awesomelena/cordic-digital-upconverter/docs/phase1-report.pdf

PROJEKTNI ZADATAK - FAZA 1 | 1

# Hardversko-softverska obrada signala

# Projektni zadatak - Prva faza

Magdalena Savic, 2022/0351 ´

Sažetak—U ovom izvještaju je analizirana i predložena efikasna arhitektura interpolatora za promjenu ucestanosti odabira- ˇ nja signala M = 16 puta. Predložena je kaskadna realizacija sa cetiri stepena, od kojih su prva tri poluopsežni filtri. Pored ˇ toga, definisani su parametri za realizaciju kompleksnog mje-
šaca primjenom CORDIC algoritma. Odre ˇ | deni su koeficijenti ¯
kompenzacionog FIR filtra koji poništava slabljenje NRZ DAC-a u osnovnom opsegu, a na kraju je teorijski proracunato ˇ maksimalno dozvoljeno podrhtavanje takta (jitter) sistema.
I. ARHITEKTURA INTERPOLATORA

Potrebno je dizajnirati interpolator sa odnosom promjene
ucestanosti od ˇ | M = 16. Ulazni kompleksni signal ima uce- ˇ
stanost odabiranja fs = 61.44 MHz, a korisni signal zauzima opseg fmax = ±25 MHz. Umjesto direktne implementacije, koja bi zahtijevala veoma dugacak filtar zbog uske tranzicione ˇ zone, predlaže se kaskadna arhitektura od cetiri stepena inter- ˇ polacije sa faktorima M1 = M2 = M3 = M4 = 2. Arhitektura

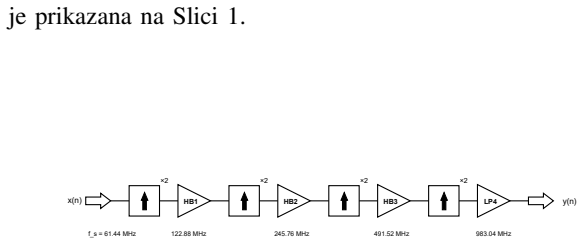
[picture p1: figure]
je prikazana na Slici 1.; f_s = 61.44 MHz; 122.88 MHz; 245.76 MHz; 491.52 MHz; 983.04 MHz

Slika 1. Predložena kaskadna arhitektura interpolatora (M = 16).

Korišcenjem kaskadne realizacije, prva tri stepena mogu ´ se realizovati kao poluopsežni (half-band) filtri, što znacaj- ˇ no smanjuje hardversku složenost jer je približno polovina koeficijenata jednaka nuli. Posljednji stepen ima najblažu tranzicionu zonu i realizuje se opštim low-pass filtrom.

A. Dizajn filtara i graniˇcne uˇcestanosti
Za svaki stepen odredene su grani ¯ | cne u ˇ | cestanosti (izražene ˇ
u odnosu na izlaznu ucestanost tog stepena) i broj koeficijenata ˇ potreban da se obezbijedi slabljenje replika od AdB = 60 dB.
Filtri su projektovani koristeci funkcije ´ | | remezhb i remezlp.
Rezultati su dati u Tabeli I.
Amplitudske karakteristike sva cetiri filtra prikazane su na ˇ Slici 2.

Univerzitet u Beogradu, Elektrotehnicki fakultet. Predmet: Hardversko- ˇ softverska obrada signala (13E044HSOS).

Tabela I
PARAMETRI STEPENA INTERPOLATORA.
Stepen | Ni | ful [MHz] | Fpass | Fstop | MOPs
HB1 (M=2) | 39 | 61.44 | 0.2035 | 0.2965 | 2396.2
HB2 (M=2) | 11 | 122.88 | 0.1017 | 0.3983 | 1351.7
HB3 (M=2) | 7 | 245.76 | 0.0509 | 0.4491 | 1720.3
LP4 (M=2) | 6 | 491.52 | 0.0254 | 0.4746 | 2949.1
Ukupno | | | | | 8417.3

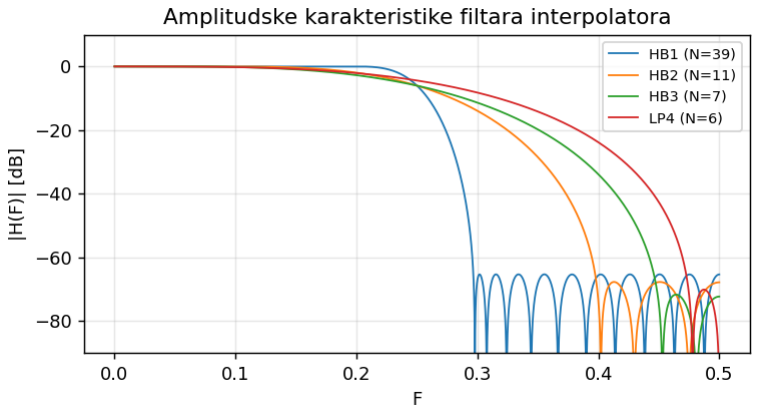
[picture p2: figure]

Slika 2. Amplitudske karakteristike filtara interpolatora.

B. Procjena broja operacija

Za polifaznu realizaciju, broj operacija u sekundi (množenje i sabiranje) zavisi od ulazne ucestanosti svakog stepena: ˇ

Nop = N1fs + N2(2fs) + N3(4fs) + N4(8fs)
≈ 8417.3 MOPs. | (1)

Ukoliko bi se implementirala direktna interpolacija (M = 16 u jednom koraku), tranziciona zona bi iznosila ∆F = (fs − fmax)/(16fs) ≈ 0.01164, što zahtijeva filtar dužine Ndir ≈ AdB/(22 ∆F) ≈ 235. U direktnoj implementaciji pretpostavlja se realizacija bez optimizacija, pa je broj operacija prosto:

Nop,dir = Ndir · fs ≈ 235 · 61.44 ≈ 14438.4 MOPs. (2)

Može se zakljuciti da kaskadna implementacija smanjuje broj ˇ operacija 14438.4/8417.3 ≈ 1.72 puta, uz znatnu uštedu na memoriji za koeficijente. Takode, pošto su prva tri filtra ¯ poluopsežna, praktican broj množenja je još manji. ˇ

C. Spektri signala u svim granama arhitekture

Spektar ulaznog signala prikazan je na Slici 3. Signal zauzima opseg od −25 do +25 MHz i nije konjugovanokompleksno simetrican. ˇ

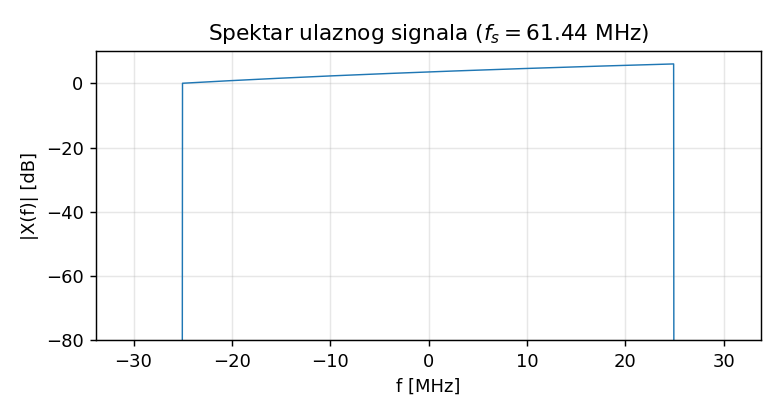
[picture p3: figure]

Slika 3. Spektar ulaznog signala (fs = 61.44 MHz).

Nakon svakog ekspandera, u spektru se pojavljuju spektralne replike, koje se zatim potiskuju odgovarajucim filtrom. ´ Slike 4–6 prikazuju spektar signala nakon ekspandera (sa ucrtanom idealnom granicom filtra) i nakon filtriranja, za prva tri (half-band) stepena.

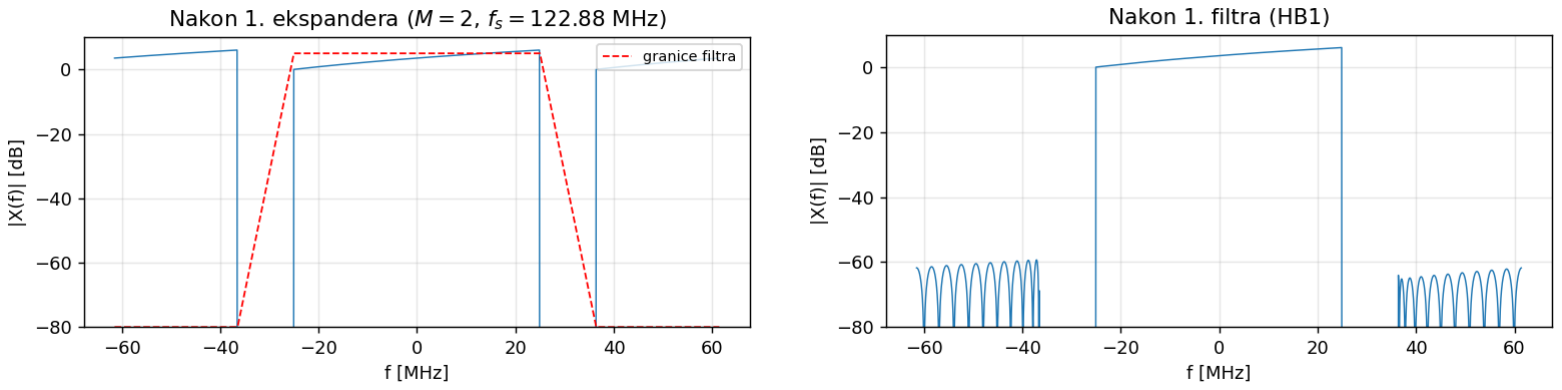
[picture p4: figure]

Slika 4. Prvi stepen (M = 2): spektar nakon ekspandera (lijevo) i nakon filtra HB1 (desno).

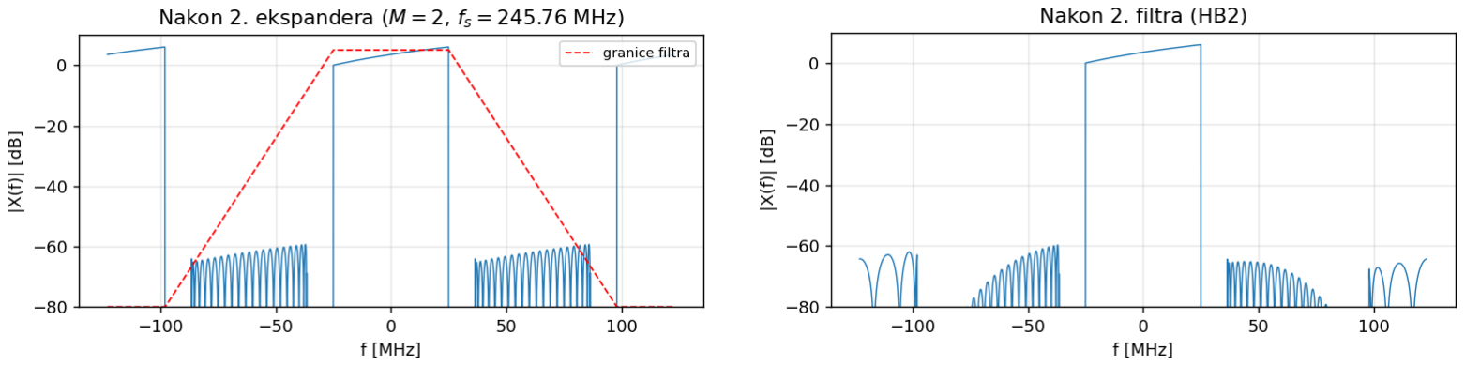
[picture p5: figure]

Slika 5. Drugi stepen (M = 2): spektar nakon ekspandera (lijevo) i nakon filtra HB2 (desno).

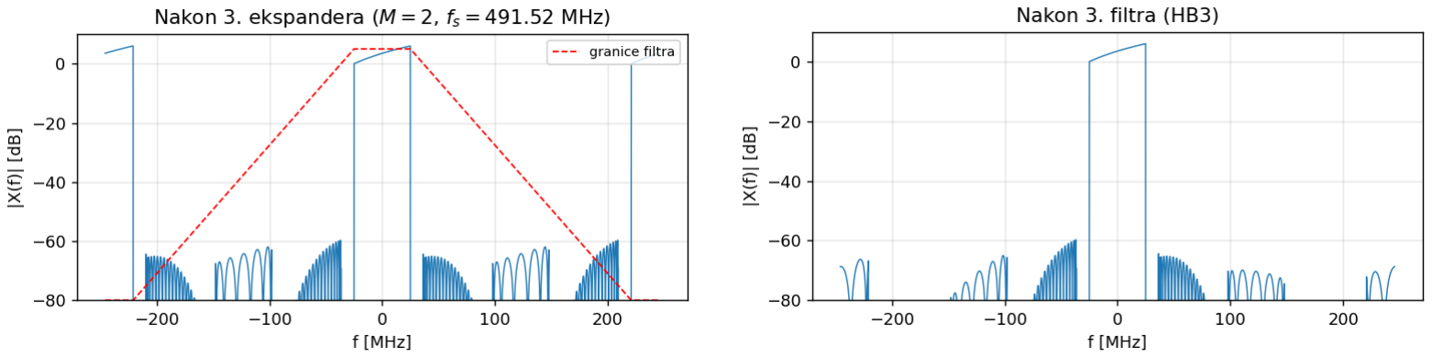
[picture p6: figure]

Slika 6. Treci stepen ( ´ | | M = 2): spektar nakon ekspandera (lijevo) i nakon
filtra HB3 (desno).
Konacno, ˇ | cetvrti (low-pass) stepen podiže u ˇ | cestanost na ˇ
983.04 MHz. Slika 7 prikazuje spektar nakon cetvrtog ek- ˇ spandera i konacni izlaz interpolatora, u kojem su sve replike ˇ potisnute ispod −45 dB.

II. CORDIC NCO I KOMPLEKSNI MJEŠACˇ

Interpolirani signal potrebno je translirati na centralnu digi-
talnu ucestanost ˇ | ω0 množenjem sa kompleksnom sinusoidom

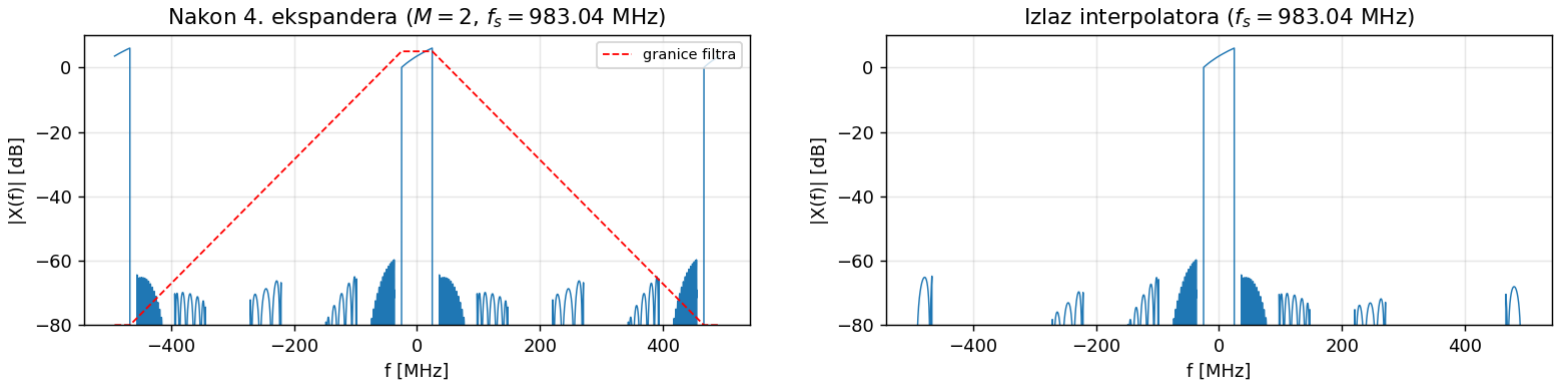
[picture p7: figure]

Slika 7. Cetvrti stepen ( ˇ | M = 2): spektar nakon ekspandera (lijevo) i konacni ˇ
izlaz interpolatora (desno).

e

jω0t
:
xejω0t = (I + jQ)(cos ω0t + j sin ω0t)

= (I cos ω0t − Q sin ω0t)
⏞ | ⏟⏟ | ⏞
ℜ{xejω0t}

+j (I sin ω0t + Q cos ω0t)
⏞ | ⏟⏟ | ⏞
ℑ{xejω0t}

(3)
CORDIC algoritam u rotacionom modu za n ≫ 1 daje:

xn ≈ K(n)

−1
[x0 cos θ − y0 sin θ], | (4)
yn ≈ K(n)

−1
[x0 sin θ + y0 cos θ]. | (5)
Poredenjem se uo ¯ | cava da se translacija u ˇ | cestanosti može ˇ
izvesti CORDIC-om ako se na ulaz x0 dovede realni dio signala I, na y0 imaginarni dio Q, a ugao rotacije θ = ω0t generiše se numericki kontrolisanim oscilatorom. Blok šema ˇ je prikazana na Slici 8.

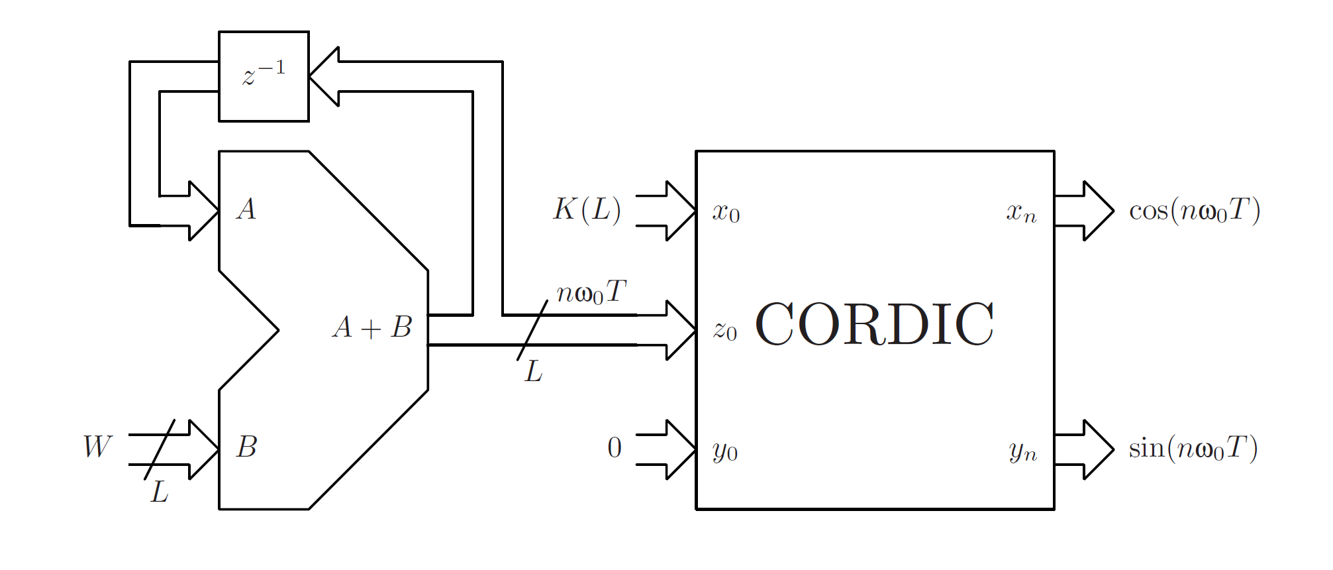
[picture p8: figure]

Slika 8. Blok šema kompleksnog mješaca sa CORDIC NCO. ˇ

Kako je rezolucija digitalno analognog konvertora (DAC) 10 bita, širina rijeci prije DAC-a treba da bude 10 bita, pa i izlaz ˇ CORDIC-a treba da ima širinu od 10 bita. Pošto se tacnost ˇ povecava za jedan bit po iteraciji, neophodno je minimum 10 ´ iteracija CORDIC algoritma. Da bi se greška usljed konacne ˇ
dužine rijeci svela ispod najmanje zna ˇ | cajnog bita (LSB), uvode ˇ
se zaštitni bitovi. Usvajaju se 4 zaštitna bita, pa ukupna širina interne rijeci iznosi 14 bita. ˇ
Da bi se obezbijedila frekvencijska rezolucija NCO od ≤ 1
Hz pri ucestanosti odabiranja ˇ | fclk = 983.04 MHz, potrebno
je odrediti širinu faznog akumulatora L. Pošto je ω0 = 2πf0 i T = f

−1
clk , a fazni akumulator dužine L bita predstavlja ugao od 2π, kontrolna rijecˇ W zadovoljava:

ω0T = W

2π
2

L

=

2πf0

fclk

=⇒ W = 2L f0

fclk

. | (6)
Najmanja ucestanost (rezolucija) odgovara ˇ | W = 1:

∆f =

fclk
2

L

≤ 1 Hz =⇒ 2

L ≥ 983.04 × 10⁶
. (7)

Iz ovog uslova slijedi L ≥ 29.87, pa se usvaja kontrolna rijecˇ širine W = L = 30 bita.

III. FIR FILTAR ZA KOMPENZACIJU NRZ ODZIVA
Zbog ZOH (Zero-Order Hold) efekta DAC konvertora u NRZ modu, spektar signala opada po funkciji sinc(F). Da bi se opadanje kompenzovalo i signal izravnao u interesantnom opsegu F ∈ [0, 0.4], primijenjen je inverzni sinc filtar, projektovan metodom najmanjih kvadrata (firls). Talasnost se definiše kao odstupanje kombinovanog odziva |Hcomp(F)| · sinc(F) od ravne karakteristike. Red filtra se
povecava dok talasnost ne "u ´ | de"u granice ¯ | ±0.025 dB. Algori-
tamskom pretragom utvrdeno je da je filtar reda 8 (9 tapova) ¯ najmanji filtar koji zadovoljava zahtjev, sa maksimalnom talasnošcu od ´ 0.020 dB. Odziv kompenzovanog sistema prikazan je na Slici 9.

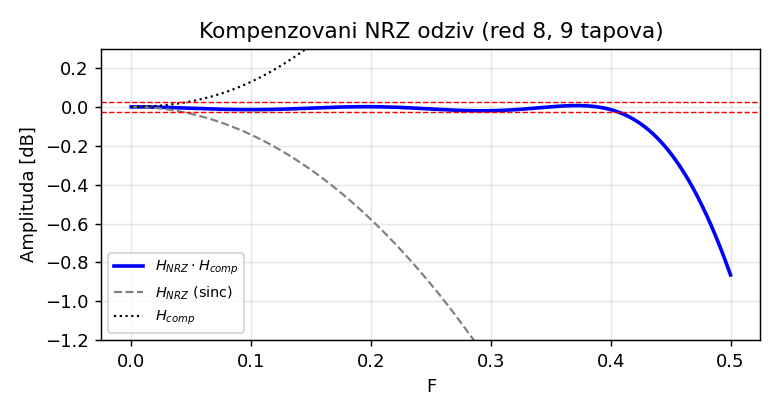
[picture p9: figure]

Slika 9. Amplitudska karakteristika kompenzovanog sistema u propusnom opsegu.

Uvecani prikaz talasnosti kombinovanog odziva dat je na ´ Slici 10, gdje se vidi da odstupanje ostaje unutar zahtijevanih ±0.025 dB u cijelom opsegu F ∈ [0, 0.4]. Vrijednosti koeficijenata normalizovanog filtra (normalizacija na jedinicno ˇ pojacanje na DC, ˇ

∑︁h[n] = 1) date su u Tabeli II.

Tabela II
KOEFICIJENTI NORMALIZOVANOG KOMPENZACIONOG FILTRA.
n | h[n]
0, 8 | +0.00242460
1, 7 | −0.00829963
2, 6 | +0.02540014
3, 5 | −0.09716800
4 | +1.15528580

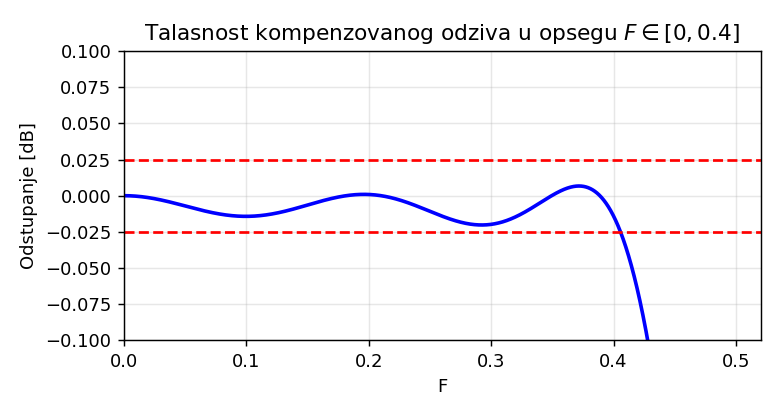
[picture p10: figure]

Slika 10. Talasnost kompenzovanog odziva u opsegu F ∈ [0, 0.4].

IV. ODNOS SIGNAL-ŠUM I JITTER
Digitalno analogni konvertor ima rezoluciju od 10 bita. Odnos signal-šum usljed kvantizacije iznosi:
SQNR = 6.02 · N + 1.76 = 61.96 dB. | (8)

Šum usljed podrhtavanja trenutka odabiranja odreduje se iz ¯ odnosa signal-šum usljed džitera aperture:
SNRj = 20 log10 (︃
1
2πfintj

)︃
. | (9)

Zahtijeva se da ovi odnosi budu izjednaceni za frekvenciju ˇ
fin = 0.9 · M · fs = 884.74 MHz. Izjednacavanjem ˇ | SNRj =
SQNR dobija se:

10

SQNR
20 =

1
2πfintj
, | (10)

odakle se izracunava maksimalno vrijeme podrhtavanja: ˇ

tj,max =

1
2πfin · 10SQNR/20 ≈ 143.55 fs. (11)
