awesomelena/cordic-digital-upconverter/docs/phase2-report.pdf

PROJEKTNI ZADATAK - FAZA 2 | 1

# Hardversko-softverska obrada signala

# Projektni zadatak - Druga faza

# Hardverska realizacija

Magdalena Savic, 2022/0351 ´

Sažetak—U ovom izvještaju je opisana protocna hardverska ˇ realizacija CORDIC algoritma u jeziku VHDL, sa parametrima odredenim u prvoj fazi projekta. Jezgro radi u rotacionom modu ¯
i koristi se kao kompleksni mješac sa numeri ˇ | cki kontrolisanim ˇ
oscilatorom. Realizacija je verifikovana poredenjem sa ta ¯ | cnim ˇ
referentnim modelom, a zatim je simuliran rad mješaca koji ˇ ulazni signal translira na centralnu ucestanost od 196.16 MHz. ˇ Postignut je odnos signal-najveci neželjeni spektralni proizvod ´ od 68.9 dB uz kašnjenje od 16 taktova i propusnost od jednog odbirka po taktu.
I. PARAMETRI REALIZACIJE
Parametri jezgra su preuzeti iz prve faze projekta i dati su u Tabeli I. Rezolucija digitalno analognog konvertora je 10 bita,
pa je usvojeno 10 CORDIC iteracija, buduci da se ta ´ | cnost ˇ
povecava za jedan bit po iteraciji. ´

Tabela I
| PARAMETRI PROTOCNOG ˇ | CORDIC JEZGRA.
Parametar | Vrijednost
Broj iteracija n | 10
Širina ulazne/izlazne rijeci | 10 bita ˇ
Zaštitni bitovi | 4
Rezerva za rast amplitude | 1 bit
Interna širina puta x, y | 15 bita
Širina akumulatora ugla z | 16 bita
Širina faznog akumulatora L | 30 bita
Kašnjenje | 16 taktova
Propusnost | 1 odbirak/takt
A. Širina internog puta podataka
| Kod kompleksnog mješaca izlaz je rotirani ulazni vektor, pa ˇ
√
amplituda pojedinacne komponente može dosti ˇ | ci´ |I + jQ| ≤
2 FS. Uz 10-bitne ulaze i 4 zaštitna bita, najgori slucaj iznosi ˇ 512√
2·2

4 = 11585, što prelazi opseg 14-bitne rijeci ( ˇ ±8191). Zbog toga je uveden jedan dodatni bit rezerve, pa interni put ima 15 bita.

B. Kompenzacija faktora K
Multiplikativni faktor iznosi K(10) = 0.607253, odnosno pojacanje ˇ K⁻¹ = 1.6468. Umjesto kompenzacije na izlazu, ulazni odbirci se unaprijed množe konstantom
| Kfix = round (︁ | K(10) · 2

15)︁
= 19898, | (1)
cime izlaz dobija jedini ˇ | cno poja ˇ | canje i može se direktno ˇ
odsjeci na 10 bita. Množenje konstantom zauzima dva DSP ´ bloka.
| Univerzitet u Beogradu, Elektrotehnicki fakultet. Predmet: Hardversko- ˇ
softverska obrada signala (13E044HSOS).
C. Predrotacija kvadranta
CORDIC u rotacionom modu konvergira samo za

|z0| ≤ θmax =

∑︂

9

i=0

arctan 2⁻i = 1.7413 rad (99.77◦ ), (2)

dok faza NCO pokriva pun opseg [0, 2π). Zbog toga se dva najviša bita faze koriste za odredivanje kvadranta, a ostatak ¯ faze leži u opsegu [0, π/2), što je unutar oblasti konvergencije. Predrotacija se svodi na zamjenu i promjenu znaka komponenti i ne zahtijeva množace. ˇ

D. Optimizacija širine akumulatora ugla
Fazni akumulator mora imati 30 bita da bi rezolucija bila ispod 1 Hz. Medutim, ¯ z-putanja unutar CORDIC-a nosi samo ostatak faze poslije izdvajanja kvadranta, pa može biti kraca. ´
Analizom je utvrdeno da se ta ¯ | cnost ne mijenja sve do 16 bita, ˇ
dok ispod te vrijednosti raste greška (Tabela II). Usvojeno je
16 bita, cime se najduži sabira ˇ | c u jezgru skra ˇ | cuje sa 30 na 16 ´
bita, što direktno smanjuje kriticnu putanju. ˇ

Tabela II
UTICAJ ŠIRINE z-PUTANJE NA TACNOST ˇ | .
Širina z [bita] | max greška [LSB] | RMS [LSB] | SFDR [dB]
30 | 1.79 | 0.73 | 68.54
20 | 1.79 | 0.73 | 68.58
16 | 1.79 | 0.73 | 68.64
14 | 2.18 | 0.76 | 65.59
12 | 3.27 | 1.04 | 64.61

II. ARHITEKTURA
Blok šema realizacije prikazana je na Slici 1 na Slici 2. Jezgro se sastoji od faznog akumulatora, stepena za skaliranje faktorom K, predrotacije kvadranta, deset identicnih CORDIC ˇ stepena i izlaznog stepena za zaokruživanje i saturaciju.

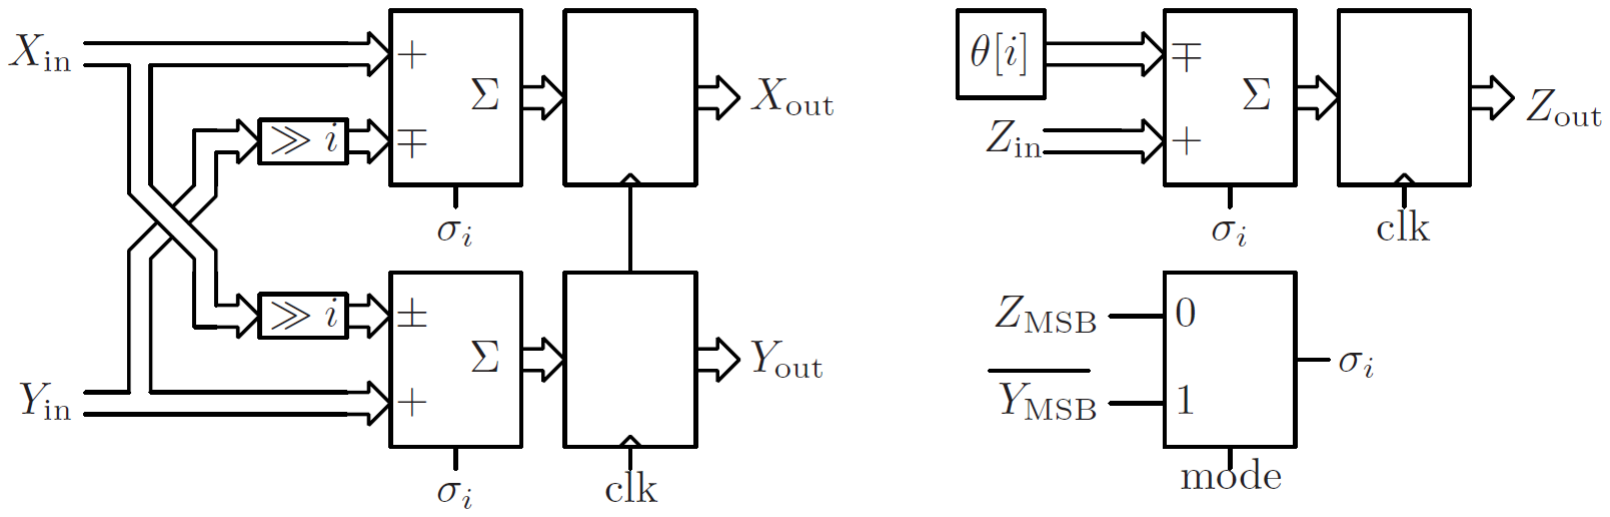
[picture p11: figure]

Slika 1. Blok šema jednog stepena protocnog CORDIC kompleksnog ˇ mješaca. ˇ

PROJEKTNI ZADATAK - FAZA 2 | 2

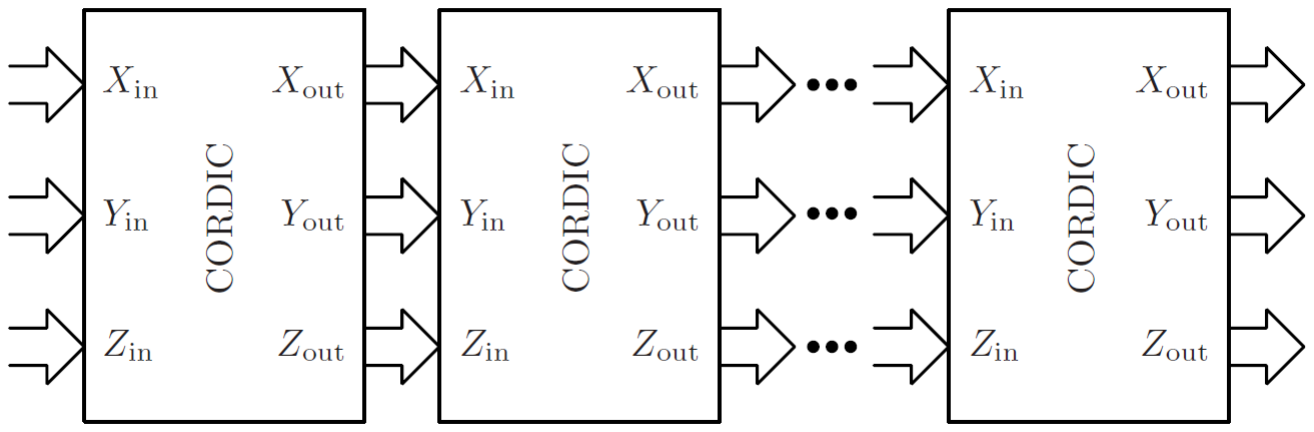
[picture p12: figure]

Slika 2. Blok šema protocnog CORDIC kompleksnog mješa ˇ | ca. ˇ

Svaki protocni stepen realizuje jednu iteraciju ˇ

xi+1 = xi − σi (yi ≫ i), | (3)
yi+1 = yi + σi (xi ≫ i), | (4)
zi+1 = zi − σi θ[i], | (5)

gdje je σi = sgn(zi), odnosno u hardveru prosto invertovani najviši bit akumulatora ugla. Pomijeranja su fiksna i realizuju se povezivanjem, pa ne troše resurse. Svi izlazi stepena su registrovani, cime se dobija jedan takt kašnjenja po stepenu ˇ
i kratka kriticna putanja koja sadrži samo jedan sabira ˇ | c i ˇ
multiplekser.

III. VERIFIKACIJA
Ispravnost realizacije provjerena je poredenjem sa refe- ¯ rentnim modelom napisanim u Pythonu. Samoprovjeravajuci´ testbenc propušta 16384 odbirka interpoliranog test signala ˇ kroz jezgro i poredi svaki izlazni odbirak sa referencom, a svako neslaganje prekida simulaciju.
Simulacija je pokazala potpuno poklapanje na svim provjerenim odbircima. Da bi se potvrdilo da provjera zaista može da otkrije grešku, u referentni niz je namjerno unesena greška od
3 LSB, nakon cega je testben ˇ | c prijavio neslaganje i prekinuo ˇ
simulaciju.

IV. REZULTATI SIMULACIJE
A. Cisto´ca spektra oscilatora ˇ

Sa konstantnim ulazom I = 511, Q = 0 jezgro se ponaša kao numericki kontrolisani oscilator. Uz koherentno odabiranje ˇ (3269 perioda u 16384 odbirka) dobija se spektar prikazan na Slici 3. Postignuti odnos signal-najveci neželjeni proizvod ´ iznosi SFDR = 68.9 dB, što je iznad teorijskog odnosa signalšum kvantizacije za 10 bita (61.96 dB).

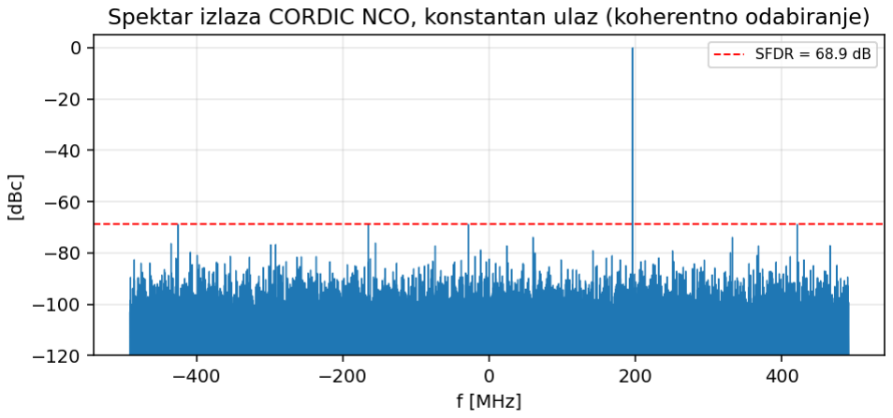
[picture p13: figure]

Slika 3. Spektar izlaza CORDIC NCO pri konstantnom ulazu.

B. Rad u modu kompleksnog mješaˇca
Kontrolna rijec za centralnu u ˇ | cestanost ˇ | f0 = 196.16 MHz
pri fclk = 983.04 MHz iznosi
W = round (︃
2

30 f0

| fclk )︃
= 214259029, | (6)
cime se dobija ˇ | f0 = 196.160000 MHz uz grešku manju od
1 Hz. Na ulaz jezgra doveden je interpolirani test signal iz prve faze, kvantizovan na 10 bita. Spektri ulaznog i izlaznog signala prikazani su na Slici 4. Signal koji je u osnovnom opsegu zauzimao ±25 MHz preslikan je u opseg oko 196.16 MHz,
a težišna ucestanost izlaznog spektra potvr ˇ | | duje pomjeraj od ¯
196.15 MHz.

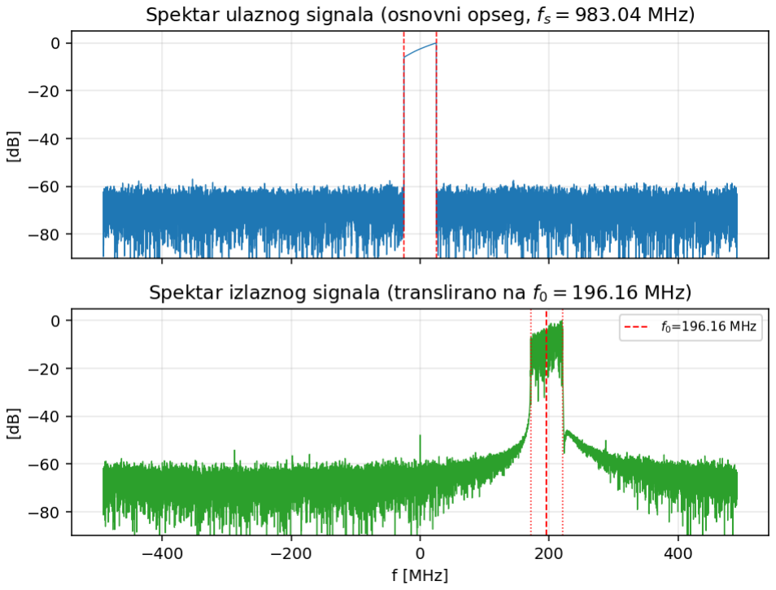
[picture p14: figure]

Slika 4. Spektri ulaznog (gore) i izlaznog (dole) signala kompleksnog mješaca. ˇ

V. IMPLEMENTACIJA NA PYNQ-Z2
Zauzece resursa na kolu XC7Z020, dobijeno sintezom u ´ alatu Vivado, dato je u Tabeli III. Jezgro je vrlo malo, pa je raspoloživo dovoljno resursa za višestruku paralelizaciju.

Tabela III
ZAUZECE RESURSA POSLIJE SINTEZE ´ | | | (XC7Z020).
Resurs | Utrošeno | Raspoloživo | Iskorišcenost ´
LUT | 517 | 53200 | 1.0 %
FF | 535 | 106400 | 0.5 %
Slice | 180 | 13300 | 1.4 %
DSP | 2 | 220 | 0.9 %

Optimizacija radne ucestanosti sprovedena je u dva koraka, ˇ na osnovu izvještaja o vremenskim ogranicenjima. ˇ
U prvom koraku je uoceno da se najkriti ˇ | cnija putanja ne ˇ
nalazi izmedu CORDIC stepena, ve ¯ | | c na izlazu jezgra, gdje ´
su zaokruživanje i saturacija bili realizovani u jednom taktu (šest nivoa logike). Ta operacija je razdvojena u dva protocna ˇ stepena, a saturacija je realizovana provjerom bitova iznad znaka umjesto poredenjem sa punom skalom. ¯
U drugom koraku kriticna putanja se pomjerila na pre- ˇ drotaciju kvadranta, koja je bila smještena poslije skaliranja faktorom K, pa se negacija izvodila nad 15-bitnim rijecima. ˇ

PROJEKTNI ZADATAK - FAZA 2

3

Zamjenom redoslijeda – predrotacija se sada izvodi nad ulaznim 10-bitnim odbircima, a tek zatim slijedi skaliranje – prenosni lanac negacije skracen je sa 15 na 11 bita. Kako ´ su obje operacije linearne, redoslijed ne mijenja rezultat osim
u zaokruživanju, što je potvrdeno ponovnim pore ¯ | denjem sa ¯
referentnim modelom.
Kašnjenje jezgra time raste sa 13 na 16 taktova, dok propusnost ostaje nepromijenjena – jedan odbirak po taktu. Poslije opisanih izmjena implementacija ispunjava sva za-
data vremenska ogranicenja pri periodi takta od ˇ | | | 3.150 ns, što
odgovara radnoj ucestanosti od ˇ | 317

5 MHz. Worst Negative
Slack iznosi +0

.281 ns, Worst Hold Slack +0

| | | .021 ns, a Worst
Pulse Width Slack +0

.595 ns, bez ijedne neispunjene tacke. ˇ
Najkriticnija putanja se nalazi unutar CORDIC jezgra, izme ˇ | du¯
dva susjedna stepena, i polazi od najvišeg bita akumulatora ugla. Taj bit je upravo znak

σ
i

, koji upravlja svim sabiracima ˇ narednog stepena – za

x
| ,

y
i
| | z zajedno 46 tacaka, sa izmje- ˇ
renim grananjem (fanout) od 41. Radnu ucestanost, dakle, ne ˇ
ogranicava dužina sabira ˇ | ca nego grananje upravlja ˇ | ckog signa- ˇ
la. Time je optimizacija dovedena do granice koju postavlja sama struktura, a ne pomocna logika. ´
Pri odredivanju radne u ¯ | cestanosti koriš ˇ | cen je najkra ´ | ci period ´
pri kojem implementacija u cjelini prolazi, a ne vrijednost dobijena iz izraza

1

/

(
T
| − W NS

). Razlog je u tome što se dužina kriticne putanje mijenja od prolaza do prolaza usljed ˇ razlika u razmještaju i ožicenju; u ovom radu je izmjereno ˇ rasipanje od

0

.24 ns, pa bi ekstrapolacija bila nepouzdana. Pri analizi vremenskih ogranicenja bitno je iz analize is- ˇ
kljuciti putanje ka fizi ˇ | ckim priklju ˇ | ccima kola. Ukoliko se to ˇ
ne uradi, najkriticnija putanja postaje izlazni bafer (kašnjenje ˇ oko

3

3 ns), pa dobijeni rezultat opisuje ulazno-izlazne bafere, a ne logiku CORDIC jezgra, koje je predvideno za upotrebu ¯ kao blok unutar veceg sistema. ´
Sistemska ucestanost odabiranja od ˇ | | 983 | .04 MHz je znatno
iznad mogucnosti programabilne logike kola Zynq-7020 br- ´ zinske klase

−
| 1, a ostvarena radna ucestanost jezgra iznosi ˇ
317

5 MHz. Puna propusnost se zato postiže paralelizacijom: pošto je
⌈︃
| 983 .04 MHz
| 317 .5 MHz

⌉︃
| | = 4
, | (7)
potrebna su cetiri paralelna CORDIC jezgra koja obra ˇ | | | duju uza- ¯
stopne odbirke, uz odgovarajuce pomjerene fazne akumulatore ´ (Wk = kW, pocetna faza ˇ | | k W). Uz zauzece od svega 1 % ´

logike po jezgru, cetiri kanala i dalje zauzimaju manje od 5 % ˇ kola.
